prahaas123/supersonic-uav/3-inlet-design/2d-inlet-designs.csv

Design# | "RDE inlet pressure (Pa)" | "RDE inlet speed" | "drag (N)" | "engine air mass flow 15cm span" | "mass flow ratio" | "total pressure recovery" | "Performance" | "1st cone angle (deg)" | "2nd cone turn (deg)" | "channel depth (cm)" | "cowl drop (m)" | "spike ramp angle (deg)" | "spike x-position (cm)"
1 | 114365.99999999999 | 0.91364439839112865 | 31.013978130301261 | 0.27390622667698422 | 0.98389920087443239 | 0.94461592835015296 | -0.99999997330788726 | 3 | 2 | 0.46000000000000002 | 0.0001 | 5 | 0.5
2 | 114366.00000000012 | 0.90647188067392692 | 45.710577084277844 | 0.39287936145963281 | 0.91237779917297335 | 0.94180635886294417 | -1.4738701263062362 | 8 | 2 | 0.69090909090909092 | 0.00015990016638935109 | 6.7999999999999998 | 1
3 | 114366.00000000004 | 0.93295044708436037 | 55.792747904264246 | 0.31353744302162306 | 0.95142656764443545 | 0.96123384036577963 | -1.7989548512813107 | 6.8029925187032418 | 3 | 0.50909090909090915 | 0.00021980033277870219 | 2 | 0.41999999999999998
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
