prahaas123/supersonic-uav/0-results/design543/convergence_drag.png

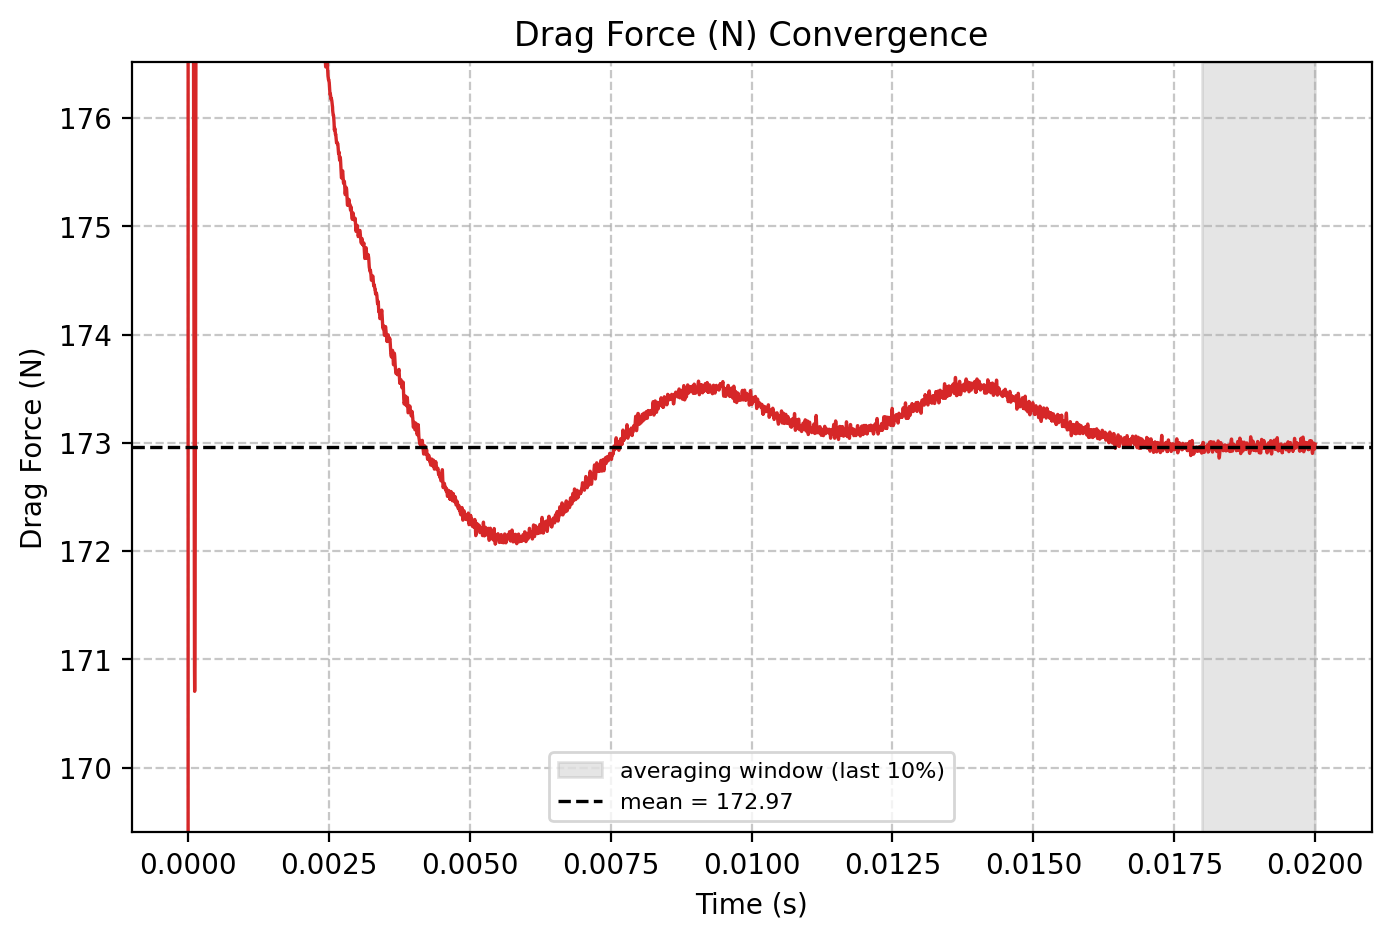
0-results/design543/convergence_drag.png
