prahaas123/supersonic-uav/0-results/design543/convergence_lift.png

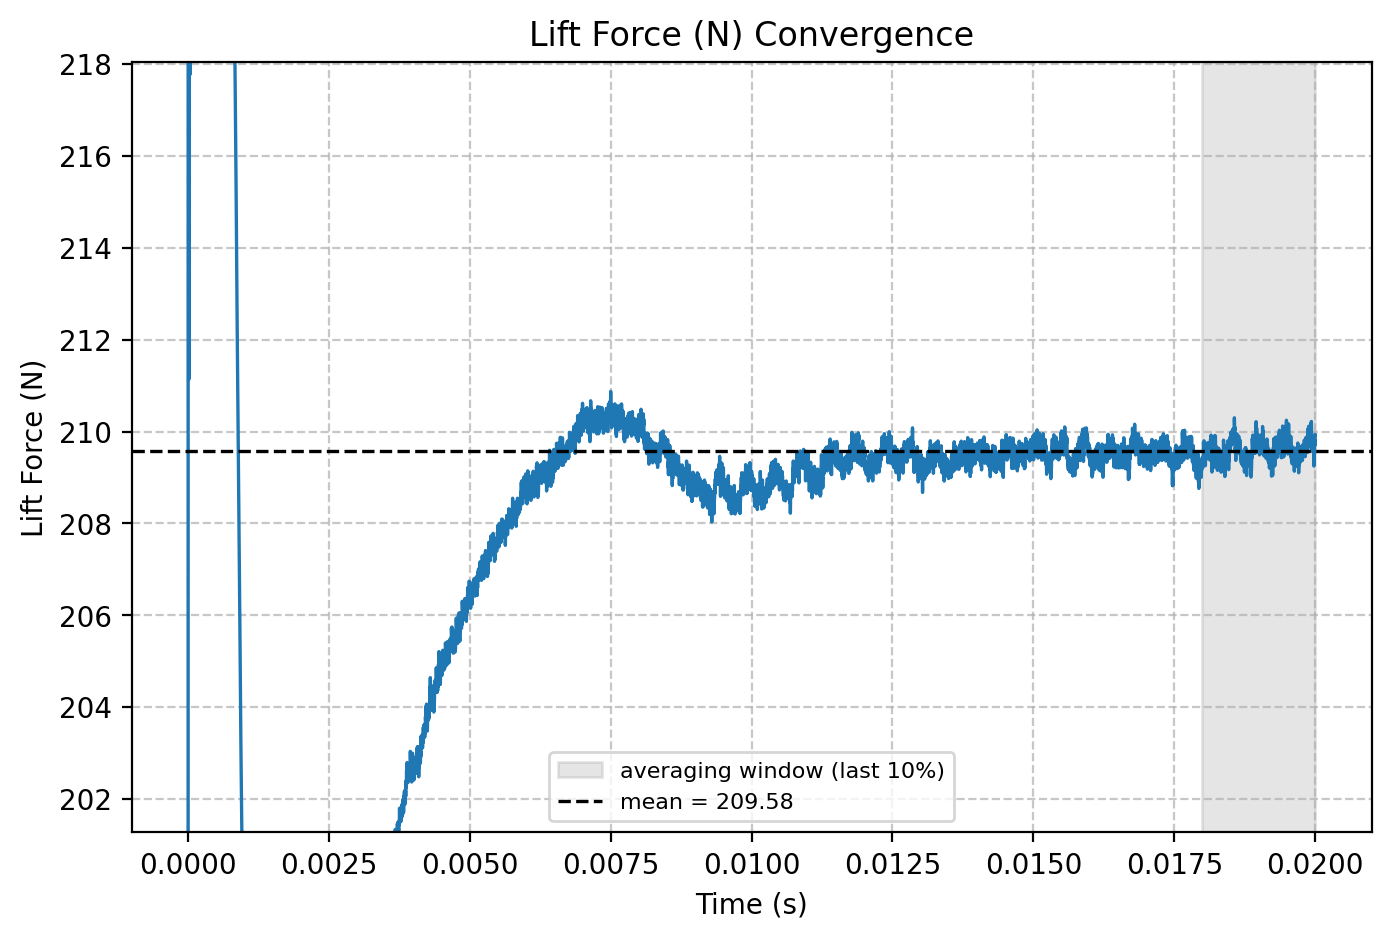
0-results/design543/convergence_lift.png
