prahaas123/supersonic-uav/0-results/design543/cp-contour-bottom.png

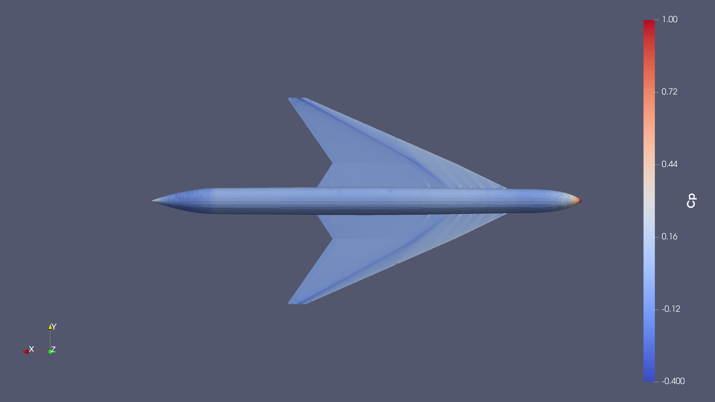
0-results/design543/cp-contour-bottom.png
