prahaas123/supersonic-uav/0-results/design543/cp-contour-diagonal.png

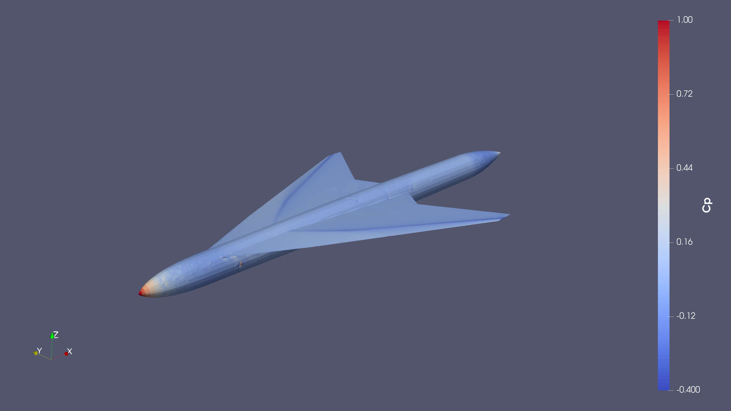
0-results/design543/cp-contour-diagonal.png
