prahaas123/supersonic-uav/0-results/design543/cp-contour-top.png

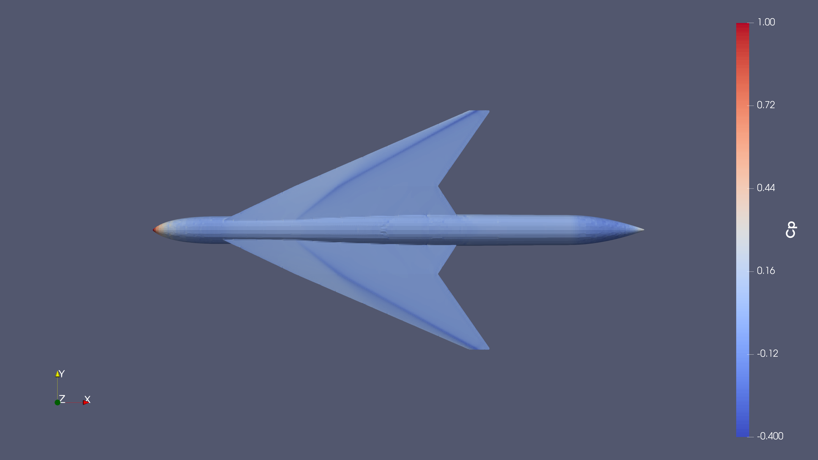
0-results/design543/cp-contour-top.png
