prahaas123/supersonic-uav/0-results/design543/geometry-bottom.png

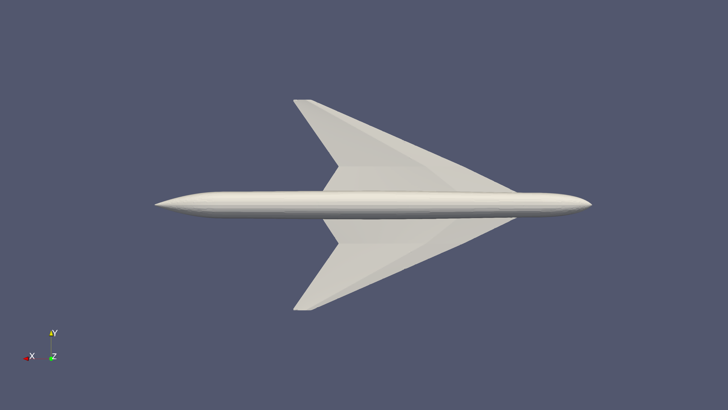
0-results/design543/geometry-bottom.png
