prahaas123/supersonic-uav/0-results/design543/geometry-top.png

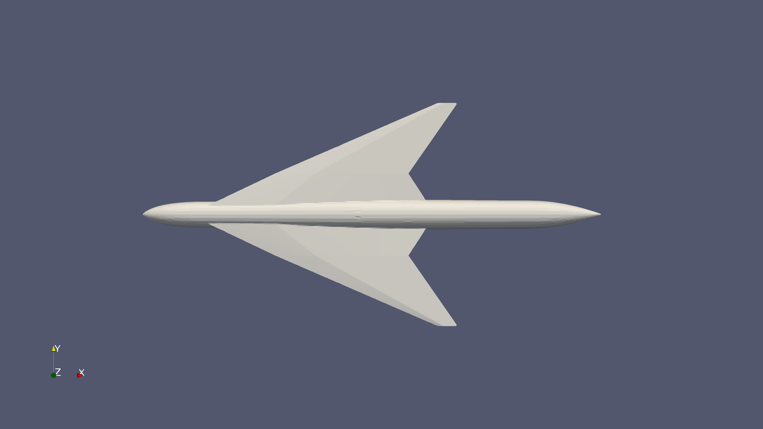
0-results/design543/geometry-top.png
