prahaas123/supersonic-uav/0-results/design543/iso-mach-diagonal.png

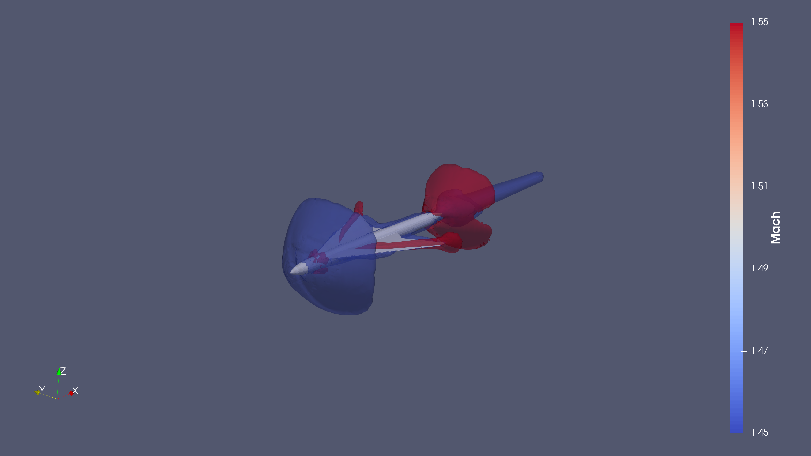
0-results/design543/iso-mach-diagonal.png
