prahaas123/supersonic-uav/0-results/design543/iso-vorticity-bottom.png

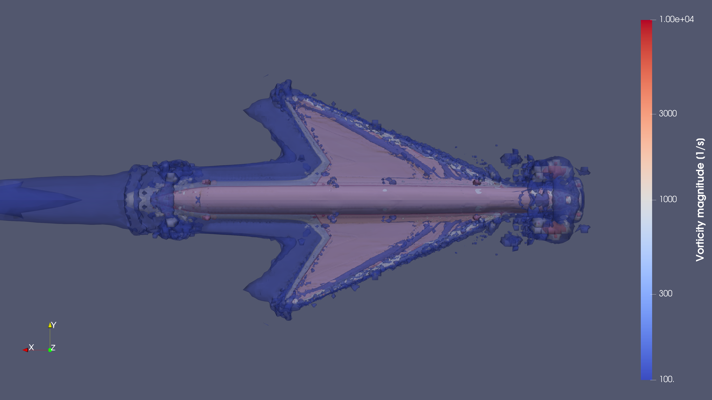
0-results/design543/iso-vorticity-bottom.png
