prahaas123/supersonic-uav/0-results/design543/iso-vorticity-top.png

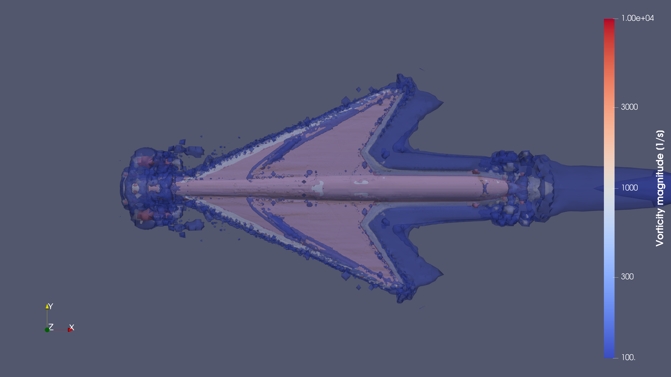
0-results/design543/iso-vorticity-top.png
