prahaas123/supersonic-uav/0-results/design543/mesh.png

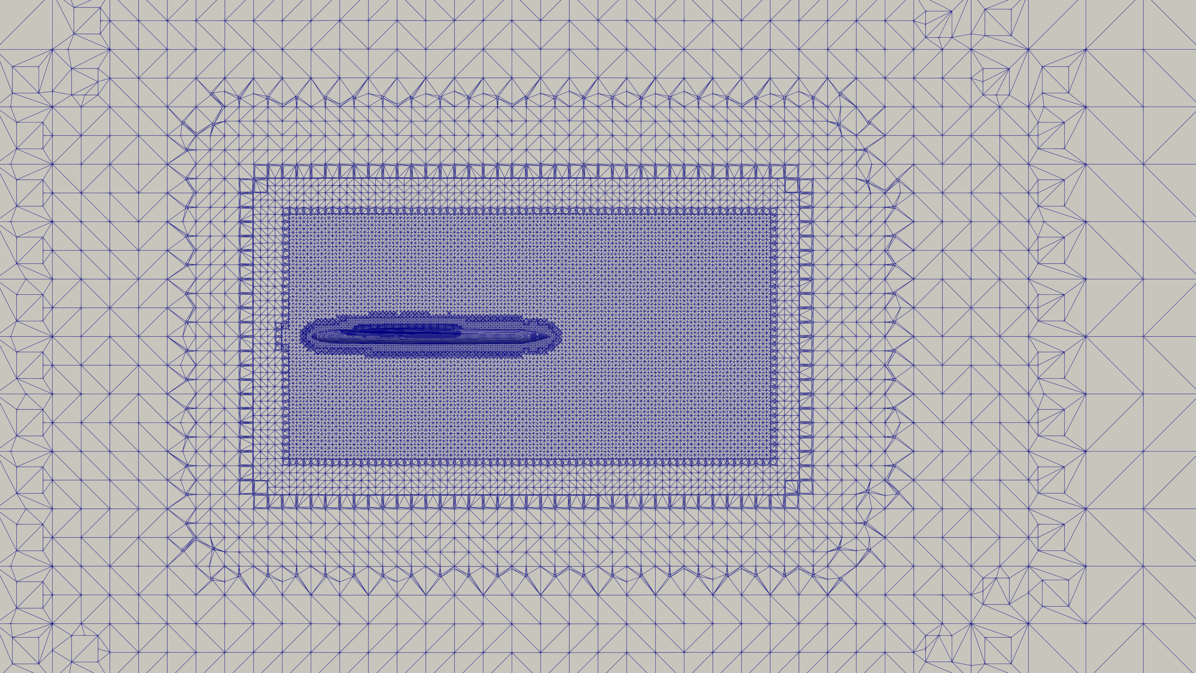
0-results/design543/mesh.png
