prahaas123/supersonic-uav/0-results/design543/residuals.png

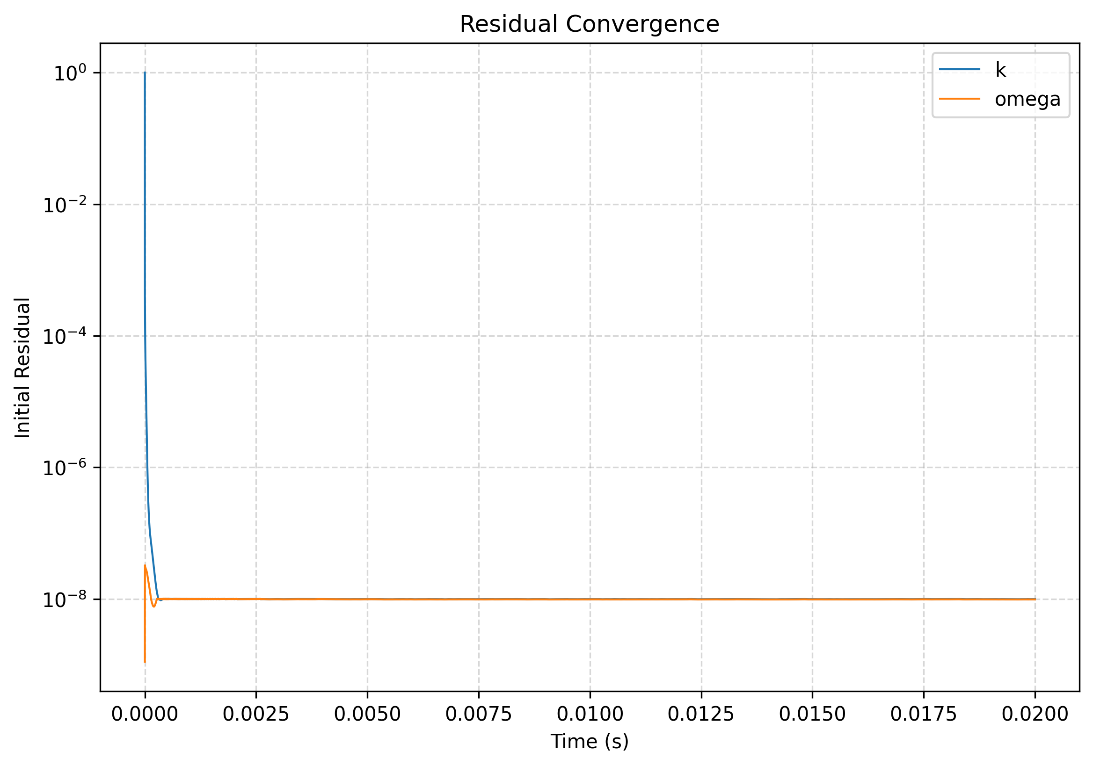
0-results/design543/residuals.png
