prahaas123/supersonic-uav/0-results/design543/slice-mach-forebody.png

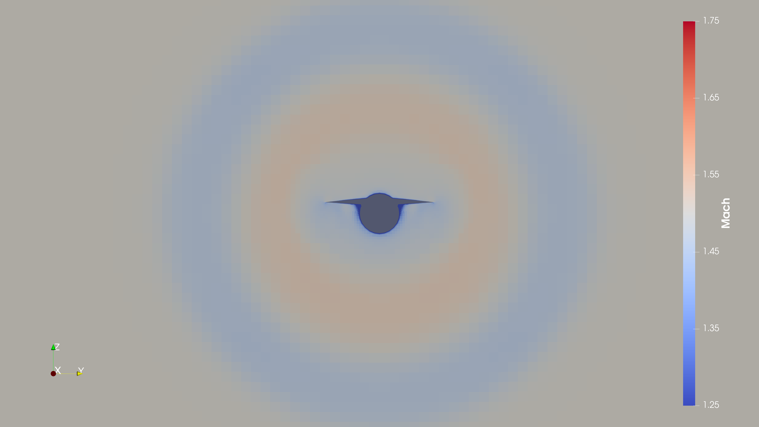
0-results/design543/slice-mach-forebody.png
