prahaas123/supersonic-uav/0-results/design543/slice-mach-wake.png

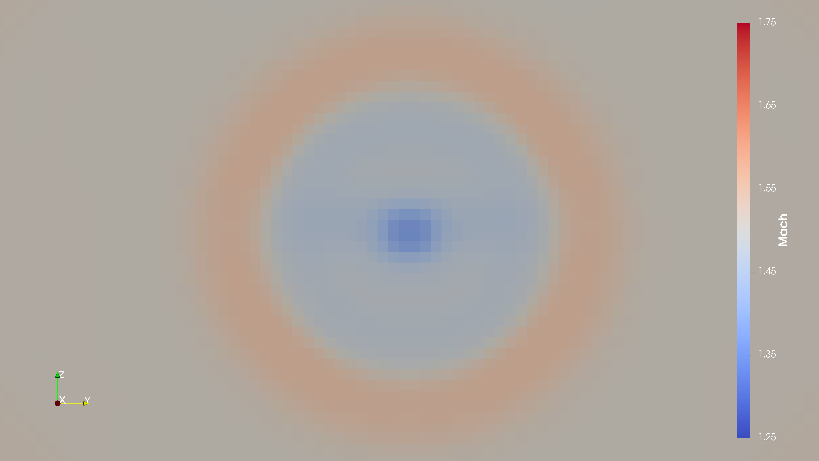
0-results/design543/slice-mach-wake.png
