prahaas123/supersonic-uav/0-results/design543/slice-pressure.png

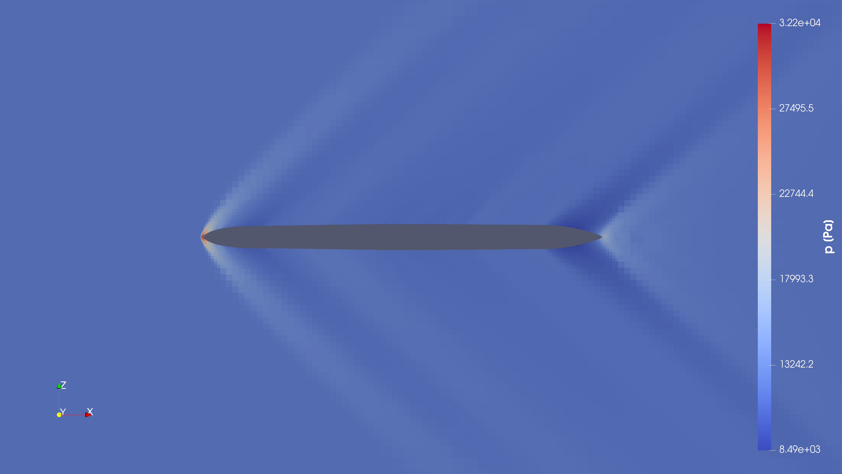
0-results/design543/slice-pressure.png
