prahaas123/supersonic-uav/0-results/design543/wall-shear-bottom.png

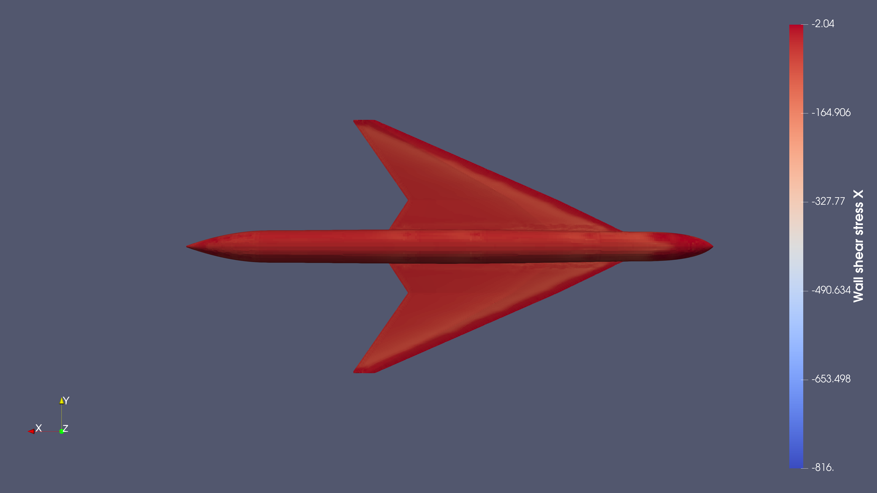
0-results/design543/wall-shear-bottom.png
