prahaas123/supersonic-uav/0-results/design543/yplus-bottom.png

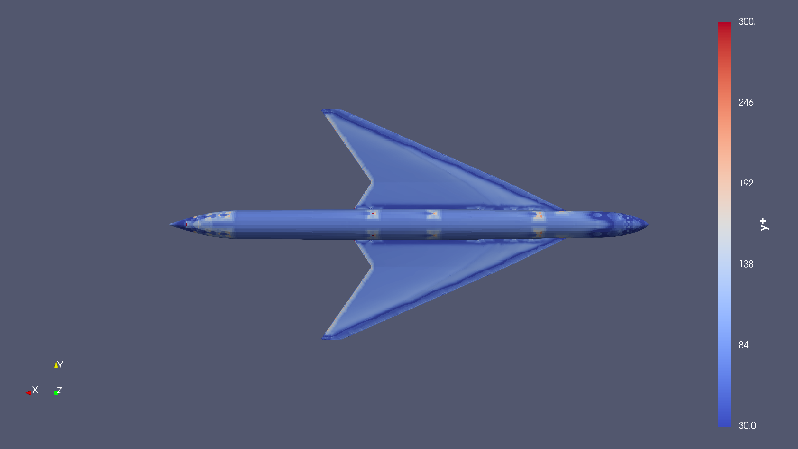
0-results/design543/yplus-bottom.png
