prahaas123/supersonic-uav/0-results/design543/yplus-diagonal.png

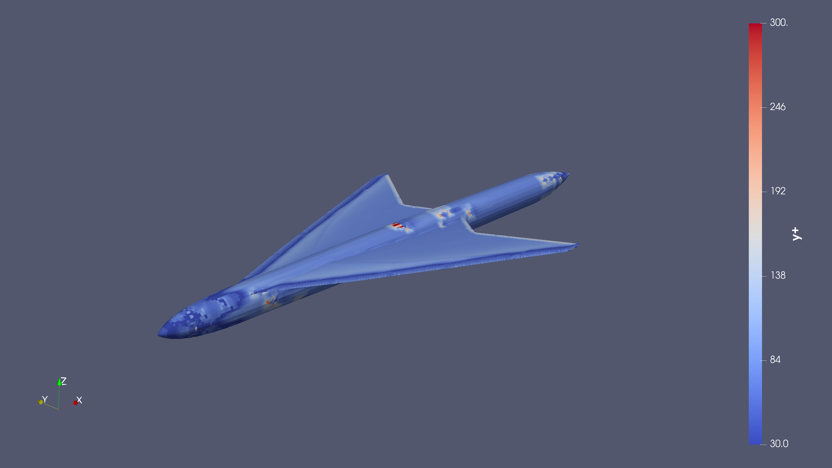
0-results/design543/yplus-diagonal.png
