prahaas123/supersonic-uav/0-results/design543/yplus-top.png

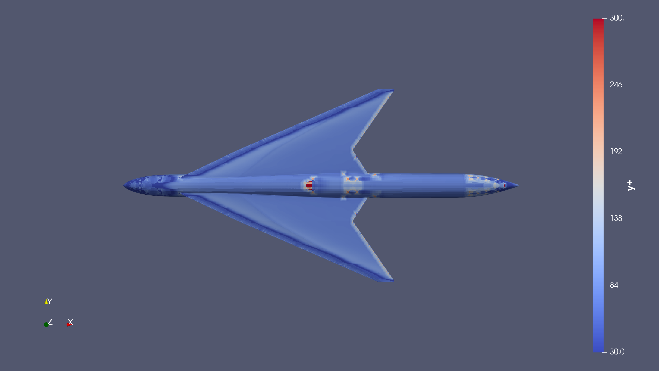
0-results/design543/yplus-top.png
