prahaas123/supersonic-uav/0-results/inlet_design_44/convergence_mass_flow.png

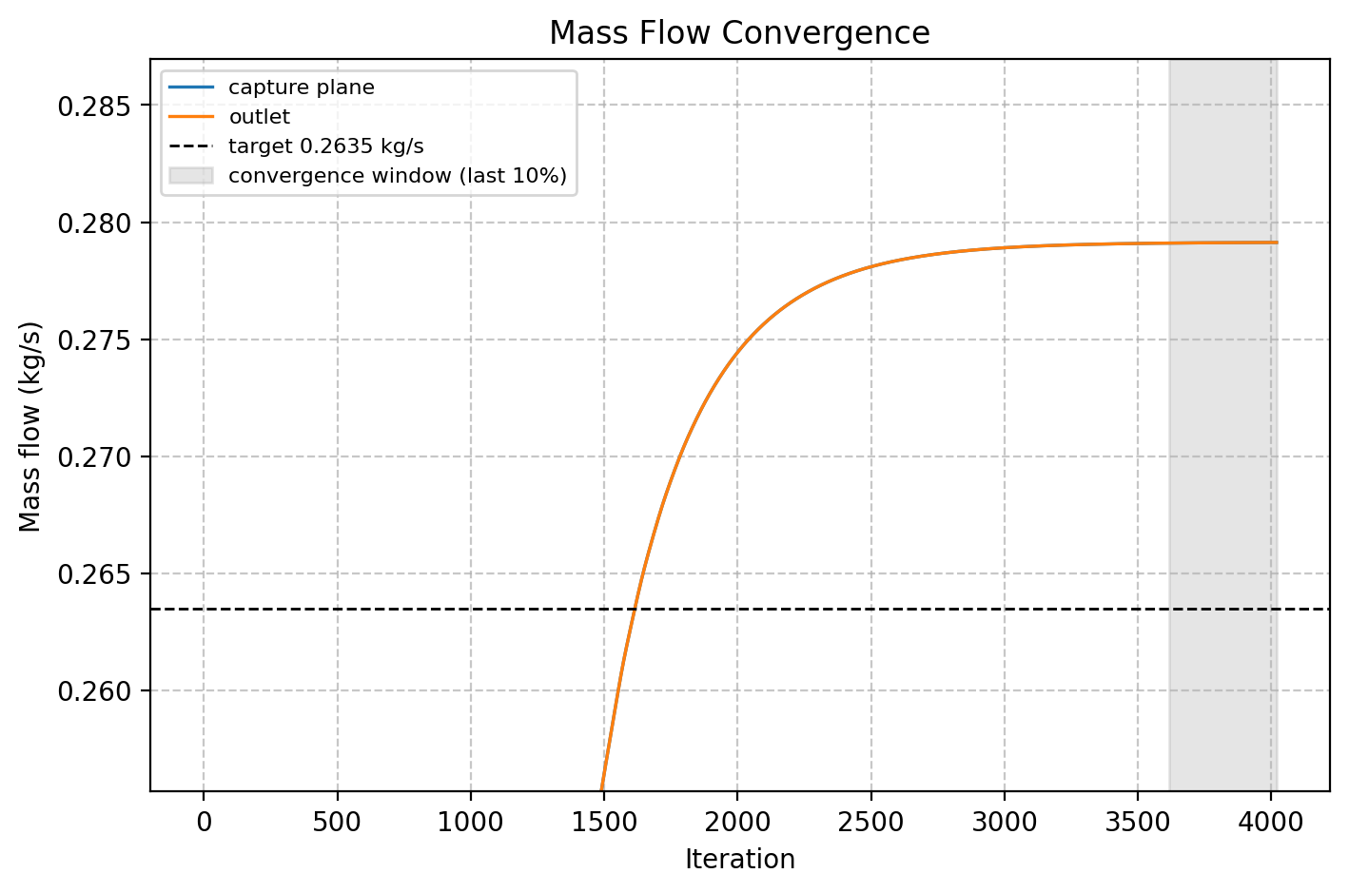
0-results/inlet_design_44/convergence_mass_flow.png
