prahaas123/supersonic-uav/0-results/inlet_design_44/residuals.png

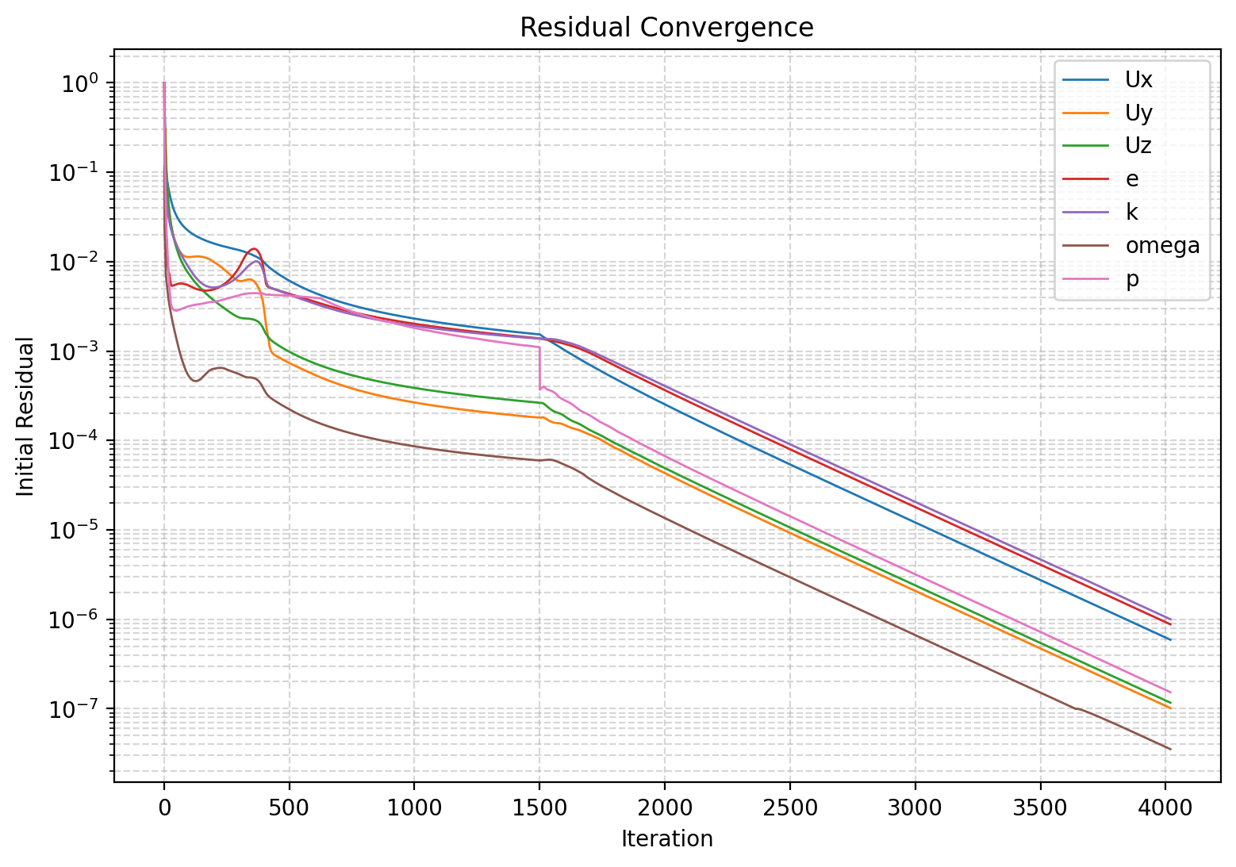
0-results/inlet_design_44/residuals.png
