prahaas123/supersonic-uav/0-results/inlet_design_44/slice-mach-side.png

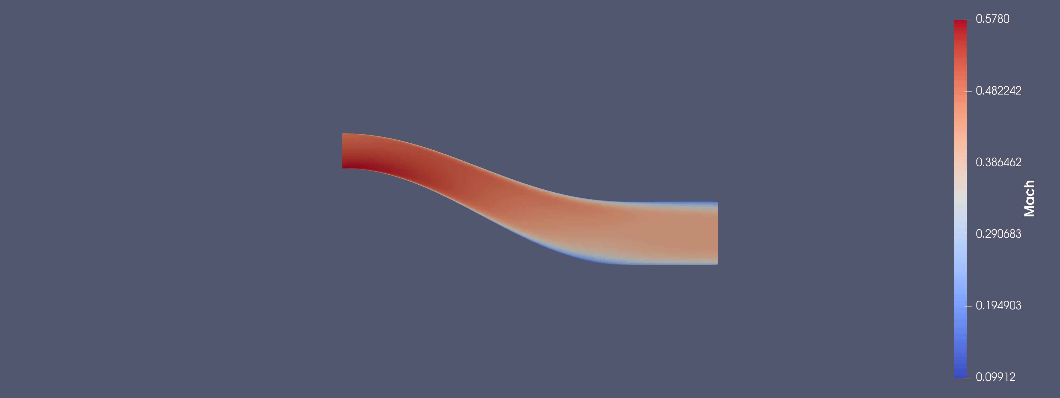
0-results/inlet_design_44/slice-mach-side.png
