prahaas123/supersonic-uav/0-results/inlet_design_44/slices-pressure-front.png

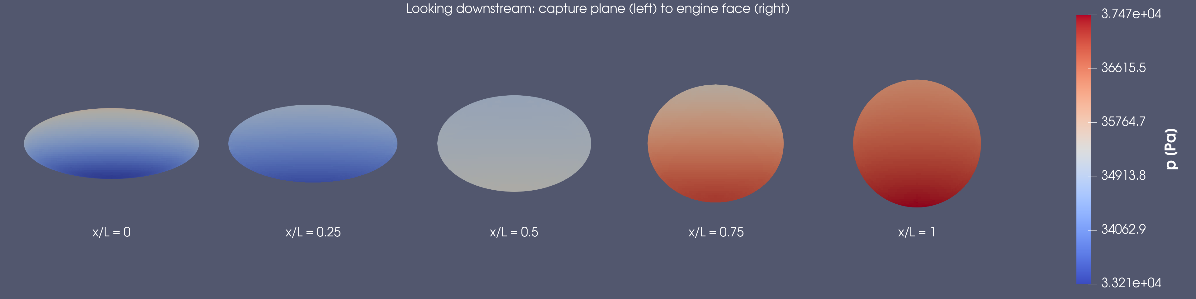
0-results/inlet_design_44/slices-pressure-front.png
