prahaas123/supersonic-uav/(list of files, cad)

Other CAD files:
4-detail-design/uav.stl
