prahaas123/supersonic-uav/0-results/inlet_dse_results.csv

design_id | LD | AR | WH | c_cl | c_area | pt_recovery_duct | reversed_flow_frac | duct_mach_max | cap_mach_avg | ef_mach_avg | ef_p_avg | mdot_outlet_kg_s | mdot_ratio | duct_length_m | wetted_area_m2 | capture_area_m2 | status | converged | failed_checks | iterations | mass_imbalance_pct | cont_err_avg | yplus_min | yplus_avg | yplus_max | duct_T_max | duct_T_pctl | duct_T_hot_frac | solve_time_s
0 | 6.04147 | 1.721315 | 3.584554 | 0.565844 | 0.432705 | 0.9728489314018941 | 3.5085861343908522e-15 | 0.7709139811626514 | 0.7388634254964198 | 0.35132271038316526 | 36775.81101451126 | 0.2586234760659448 | 0.9814932678024471 | 0.4833176 | 0.12241294993092261 | 0.0029201791919222625 | ok | True |  | 5141 | -1.8829918438226134e-06 | 4.326520357650252e-06 | 6.414288019974 | 49.89208160566 | 146.0057563413 | 323.5018615722656 | 312.6424255371094 | 3.23139058201748e-06 | 988.1
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
