prahaas123/supersonic-uav/0-results/dse_results.csv

design_id | y_rotation | seg1root_chord | seg1_taper | seg2_taper | seg1_span | seg1_sweep | seg1_twist | seg2_span | seg2_sweep | seg2_twist | tc_root | tc_break | tc_tip | thick_loc | symmetry_factor | tail_fraction | drift_tolerance_pct | status | converged | t_end | n_timesteps | drag_N | drag_std_N | drag_drift_pct | lift_N | lift_std_N | lift_drift_pct | window_start_s | n_window_samples | side_force_raw_N | drag_pressure_N | drag_viscous_N | cm_pitch_Nm | Cd | Cl | CmPitch | LD_ratio | yplus_min | yplus_max | yplus_avg | ref_area | ref_chord | cg_x | semi_span | tip_te_x | mesh_time_s | solve_time_s | total_time_s
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
