prahaas123/supersonic-uav/0-results/inlet_recovery_vs_wetted_area.png

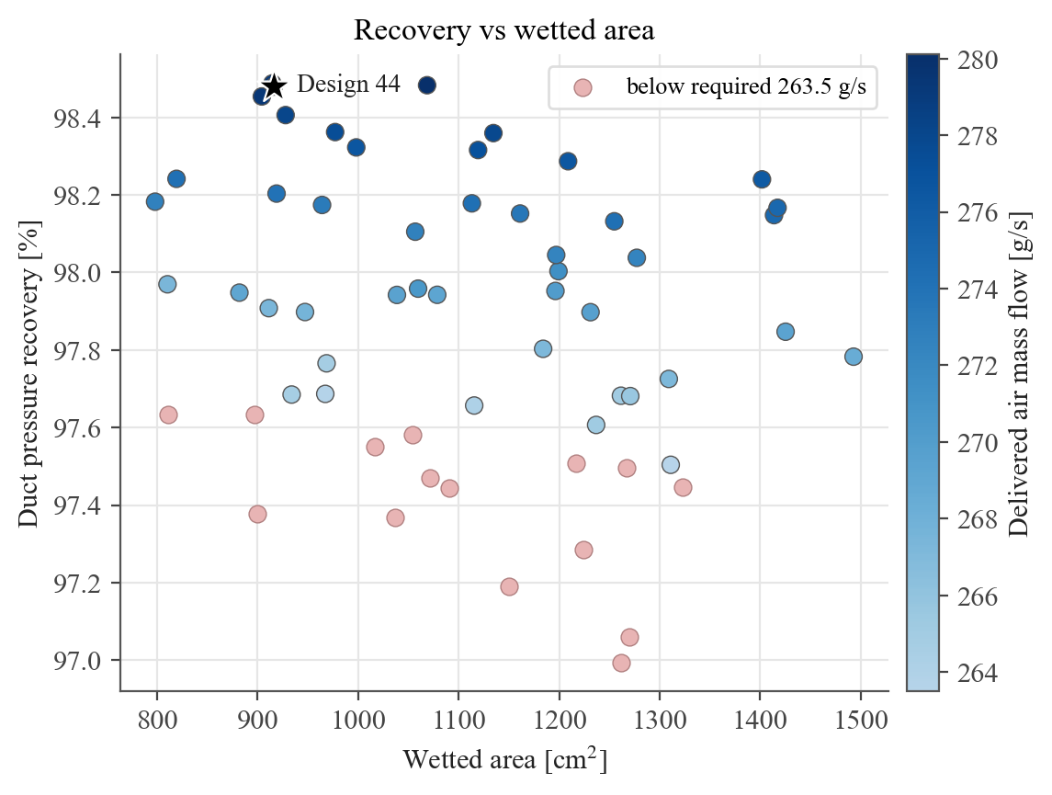
0-results/inlet_recovery_vs_wetted_area.png
