prahaas123/supersonic-uav/(commit log)

2026-05-13 openfoam templates added
    [uav.stl]
2026-05-14 working mesh, cleanup main python script
    [uav.stl]
2026-06-06 file rename & thrust estimate added
2026-06-06 deleted thrust estimator script
2026-06-09 copy stl syntax
2026-06-15 cores dependancy
    [grid_independence.csv]
2026-06-17 grid independance, core independance, wallshearstress, residual plot, increase trailing refinement
    [core_scaling.csv]
2026-06-19 reduced aoa
    [uav.stl]
2026-07-19 geometry updated
    [uav.stl]
2026-09-14 grid indepaendance results
    [grid_independence.csv]
2026-09-19 switched to level 3 mesh
2026-09-21 gemetry update
    [uav.stl]
2026-09-25 geometry location point fix
    [uav.stl]
2026-09-25 switched wall fucntion
2026-09-25 uav modified to have pointy end
    [uav.stl]
2026-09-26 increased t and reduced aoa
    [uav.stl]
2026-10-02 use parametric model for the cfd runs
    [uav.stl]
2026-10-03 grid independence done
    [grid_independence.csv]
2026-10-10 grid independance added
    [grid_independence.csv]
2026-10-11 new grid independence done and final case template
2026-10-16 restructure folders, add GP surrogate script
    - images -> 0-images, initial-sizing -> 1-initial-sizing, openfoam -> 2-optimization
    - shared create_uav/metrics/post_process moved to 0-tools, subsonic case to 3-detail-design
    - scripts updated for the new paths
    - surrogate.py: GP surrogates for lift, drag and pitching moment with 5-fold CV
2026-11-12 using eta duct est
2026-11-12 cleanup, added images, and changed duct est value
2026-11-13 stl update
2026-11-14 Stop tracking uav.stl (too large for GitHub) and ignore *.stl
